sigmondkukla/wio-e5-test/wio-e5-top.png

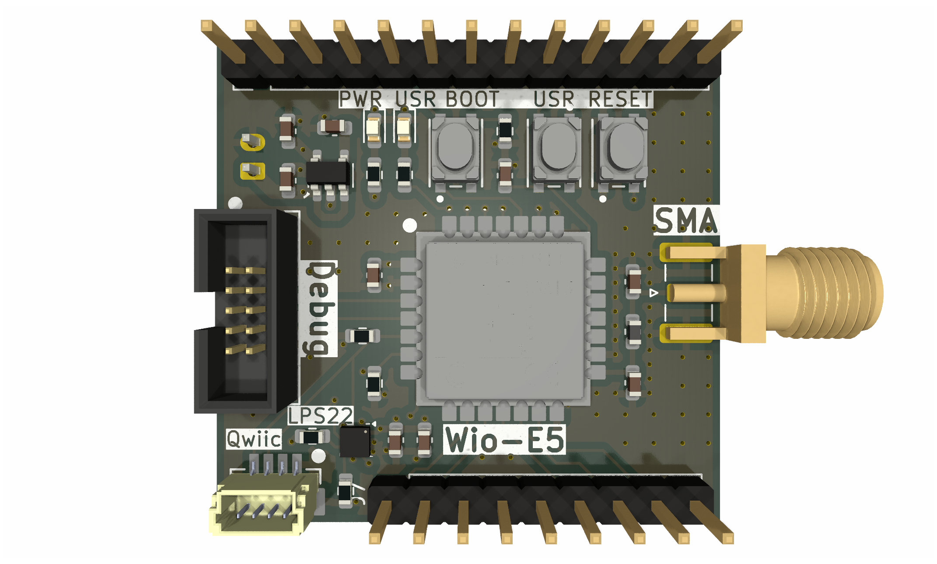
wio-e5-top.png
