sigmondkukla/wio-e5-test/plot/PCB.png

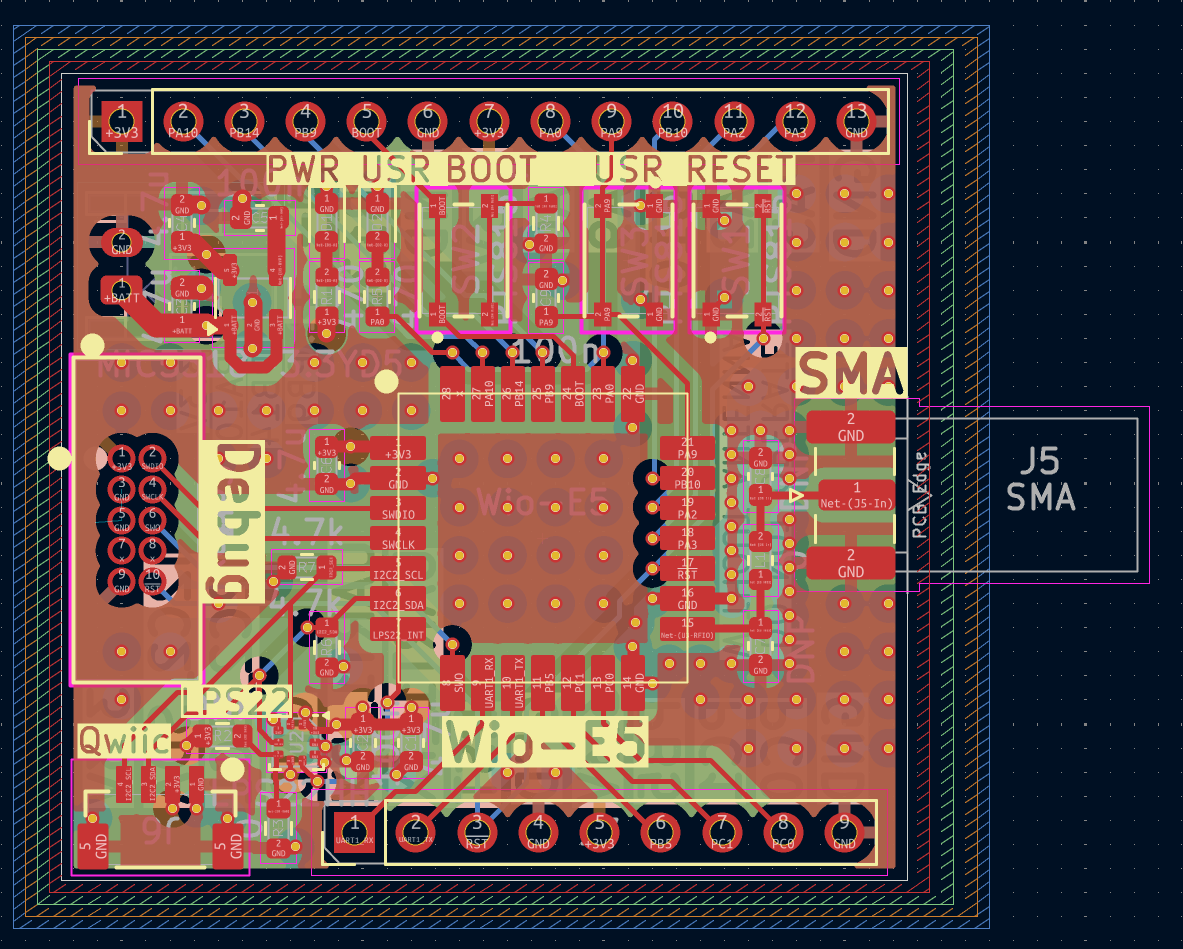
plot/PCB.png
