sigmondkukla/wio-e5-test/plot/wio-e5-test.pdf

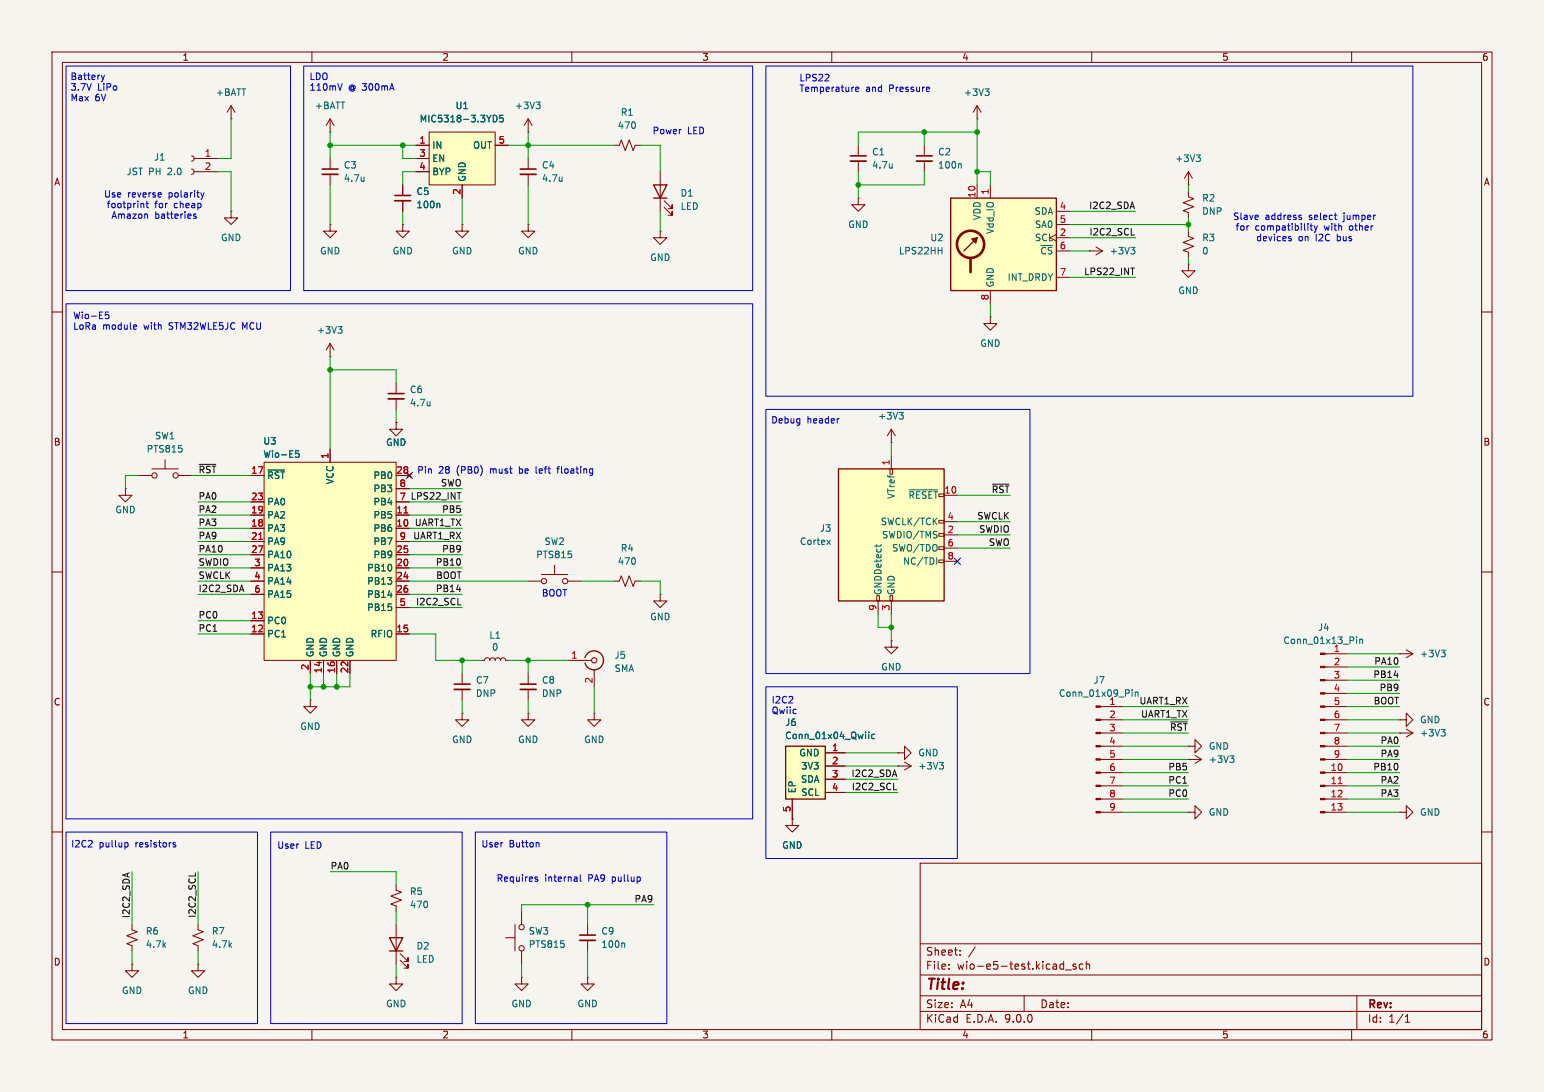
[picture p3: page 1]

1 GND 16 GND 22 PB3 8 PB4 7 PB5 11 RFIO 15 ~{RST} 17 PA2 19 PA3 18 PA13 3 PA14 4 PA15 6 PC0 13 PC1 12 PB0 28 PB6 10 PB7 9 PB9 25 PB10 20 PB13 24 PB14 26 PB15 5 C5

1 GND 16 GND 22 PB3 8 PB4 7 PB5 11 RFIO 15 ~{RST} 17 PA2 19 PA3 18 PA13 3 PA14 4 PA15 6 PC0 13 PC1 12 PB0 28 PB6 10 PB7 9 PB9 25 PB10 20 PB13 24 PB14 26 PB15 5 U3 Wio-E5 SW2 PTS815 VDD 10 Vdd_IO

R2 DNP
Slave address select jumper

LoRa module with STM32WLE5JC MCU

3 ~{RESET}10 SWCLK/TCK 4 SWDIO/TMS 2 SWO/TDO 6 NC/TDI 8

Id: 1/1 Title: File: wio-e5-test.kicad_sch Sheet: /
