sigmondkukla/wio-e5-test/wio-e5-test.kicad_pcb

## KiCad design wio-e5-test.kicad_pcb (2025-07-01)

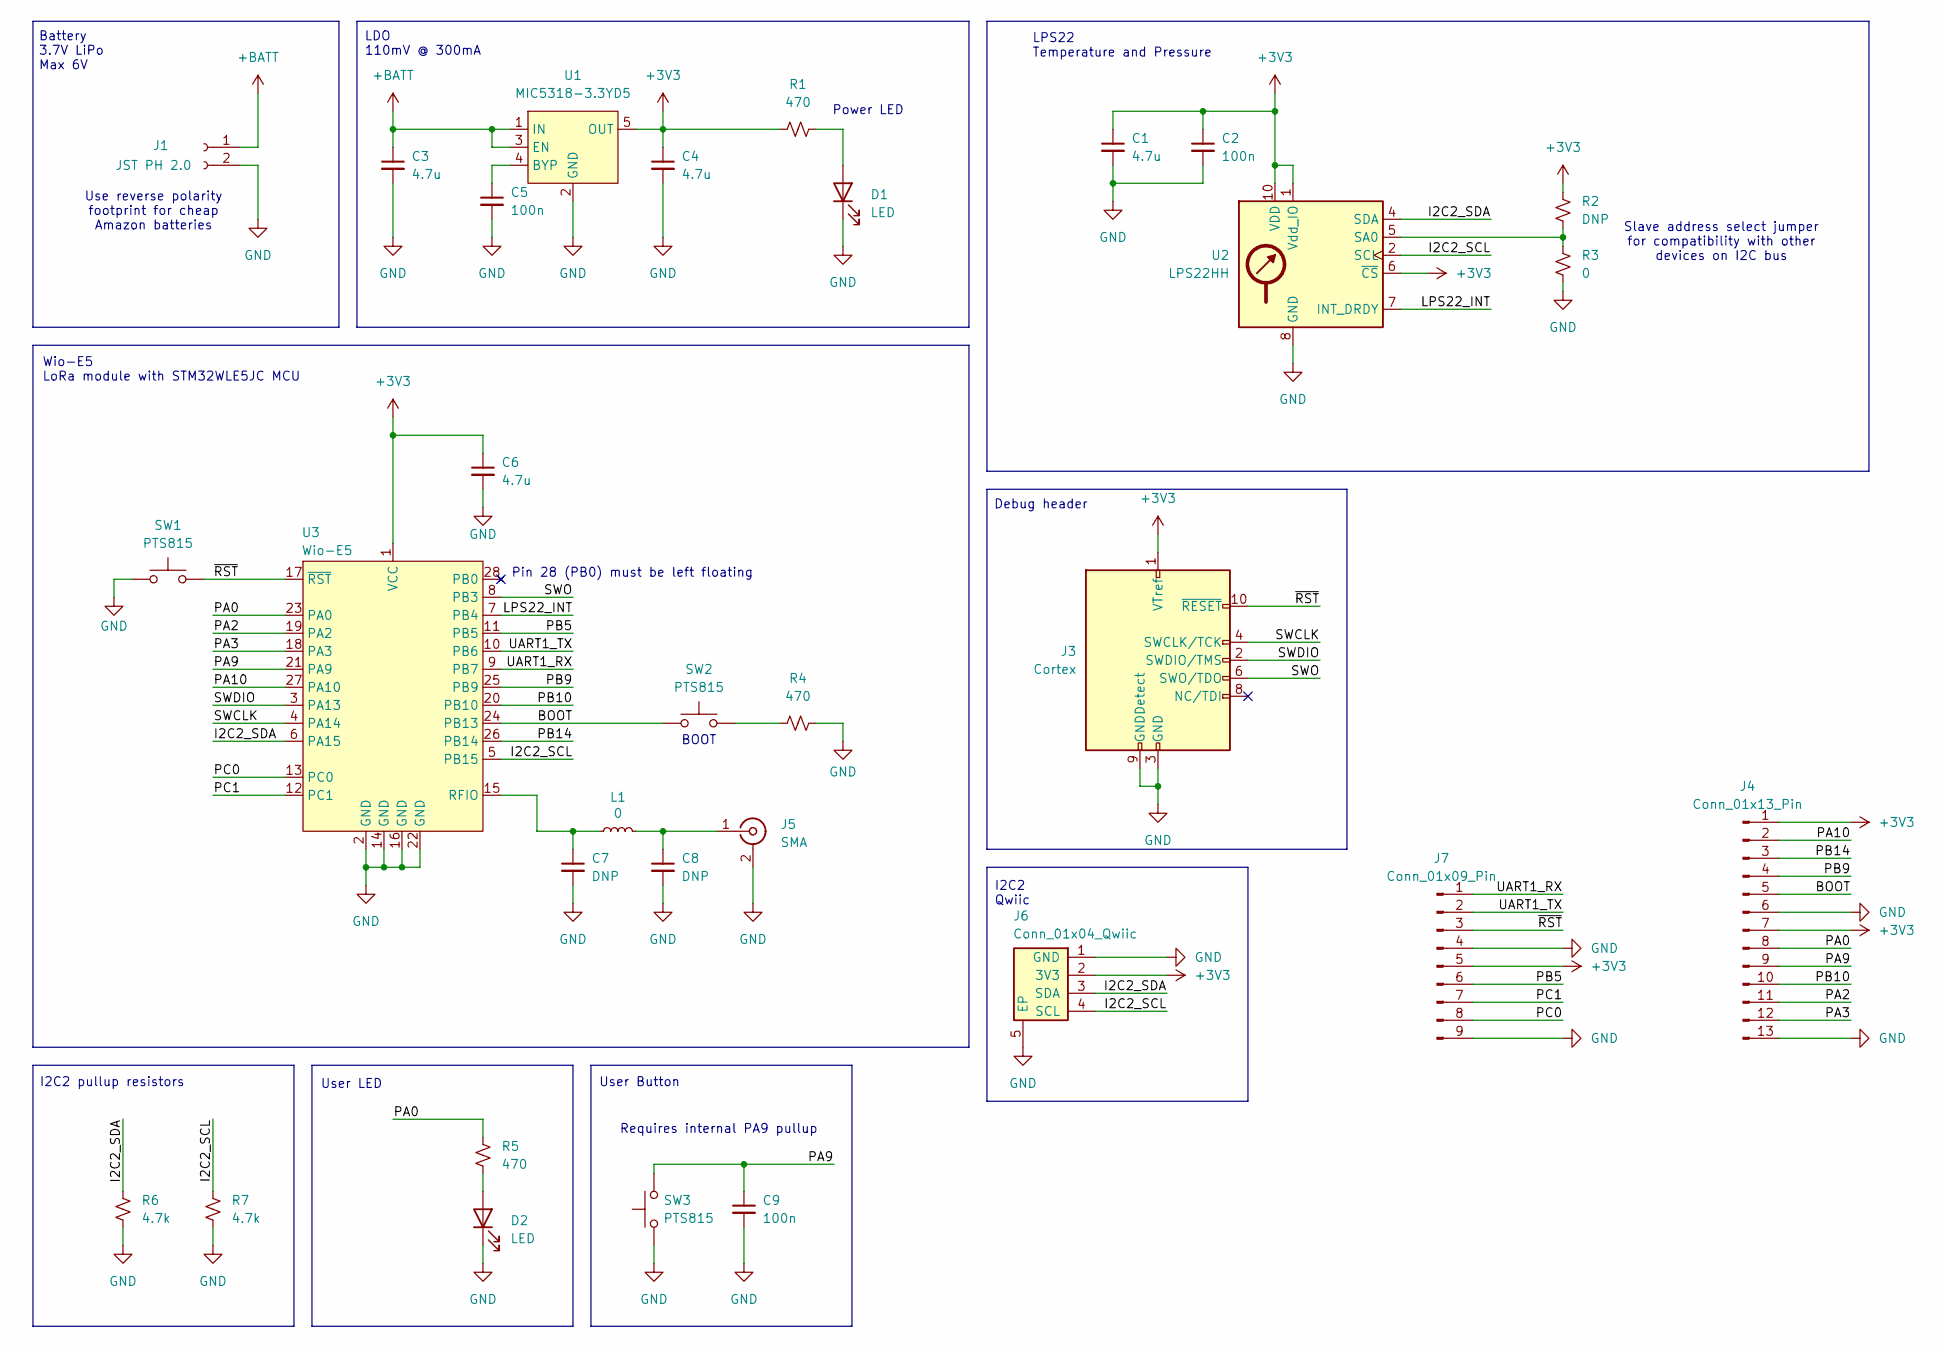
[picture p4: schematic wio-e5-test.kicad_sch]

Parts:
C1, C3, C4, C6: 4.7u; C_0603_1608Metric
C2, C5, C9: 100n; C_0603_1608Metric
C7, C8: DNP; C_0603_1608Metric
D1, D2: LED; LED_0603_1608Metric
J1: JST PH 2.0; JST_PH_S2B-PH-K_1x02_P2.00mm_Horizontal
J3: Cortex; CONN_3220-10-0100-00_CNC
J4: Conn_01x13_Pin; PinHeader_1x13_P2.54mm_Vertical
J5: SMA; SMA_Samtec_SMA-J-P-H-ST-EM1_EdgeMount
J6: Conn_01x04_Qwiic; CONN_JST-BM04B-SRSS-TB
J7: Conn_01x09_Pin; PinHeader_1x09_P2.54mm_Vertical
L1: 0; L_0603_1608Metric
R1, R4, R5: 470; R_0603_1608Metric
R2: DNP; R_0603_1608Metric
R3: 0; R_0603_1608Metric
R6, R7: 4.7k; R_0603_1608Metric
SW1, SW2, SW3: PTS815; SW_Push_PTS815_SJM_250_SMTR_LFS
U1: MIC5318-3.3YD5; SOT-23-5
U2: LPS22HH; ST_HLGA-10_2x2mm_P0.5mm_LayoutBorder3x2y
U3: Wio-E5

Connections:
+3V3: C1.1, C2.1, C4.1, C6.1, J3.1 (VTref), J4.1, J4.7, J6.2 (3V3), J7.5, R1.1, R2.1, U1.5 (OUT), U2.1 (Vdd_IO), U2.6 (~CS), U2.10 (VDD), U3.1 (VCC)
+BATT: C3.1, J1.1, U1.1 (IN), U1.3 (EN)
/BOOT: J4.5, SW2.1, U3.24 (PB13)
/I2C2_SCL: J6.4 (SCL), R7.1, U2.2 (SCL), U3.5 (PB15)
/I2C2_SDA: J6.3 (SDA), R6.1, U2.4 (SDA), U3.6 (PA15)
/LPS22_INT: U2.7 (INT_DRDY), U3.7 (PB4)
/PA0: J4.8, R5.1, U3.23 (PA0)
/PA2: J4.11, U3.19 (PA2)
/PA3: J4.12, U3.18 (PA3)
/PA9: C9.1, J4.9, SW3.2, U3.21 (PA9)
/PA10: J4.2, U3.27 (PA10)
/PB5: J7.6, U3.11 (PB5)
/PB9: J4.4, U3.25 (PB9)
/PB10: J4.10, U3.20 (PB10)
/PB14: J4.3, U3.26 (PB14)
/PC0: J7.8, U3.13 (PC0)
/PC1: J7.7, U3.12 (PC1)
/SWCLK: J3.4 (SWCLK/TCK), U3.4 (PA14)
/SWDIO: J3.2 (SWDIO/TMS), U3.3 (PA13)
/SWO: J3.6 (SWO/TDO), U3.8 (PB3)
/UART1_RX: J7.1, U3.9 (PB7)
/UART1_TX: J7.2, U3.10 (PB6)
/~RST: J3.10 (~RESET), J7.3, SW1.2, U3.17 (~RST)
GND: C1.2, C2.2, C3.2, C4.2, C5.2, C6.2, C7.2, C8.2, C9.2, D1.1 (K), D2.1 (K), J1.2, J3.3 (GND), J3.5 (GND), J3.9 (GNDDetect), J4.6, J4.13, J5.2 (Ext), J6.1 (GND), J6.5 (EP), J7.4, J7.9, R3.2, R4.2, R6.2, R7.2, SW1.1, SW3.1, U1.2 (GND), U2.3 (GND), U2.8 (GND), U2.9 (GND), U3.2 (GND), U3.14 (GND), U3.16 (GND), U3.22 (GND)
unnamed: D1.2 (A), R1.2
unnamed: D2.2 (A), R5.2
unnamed: C8.1, J5.1 (In), L1.2
unnamed: R4.1, SW2.2
unnamed: C5.1, U1.4 (BYP)
unnamed: R2.2, R3.1, U2.5 (SA0)
unnamed: C7.1, L1.1, U3.15 (RFIO)

Notes on the sheet:
LPS22 Temperature and Pressure
User Button
Slave address select jumper for compatibility with other devices on I2C bus
Wio-E5 LoRa module with STM32WLE5JC MCU
I2C2 pullup resistors
Battery 3.7V LiPo Max 6V
Power LED
I2C2 Qwiic
LDO 110mV @ 300mA
Pin 28 (PB0) must be left floating
BOOT
Requires internal PA9 pullup
Debug header
Use reverse polarity footprint for cheap Amazon batteries
User LED

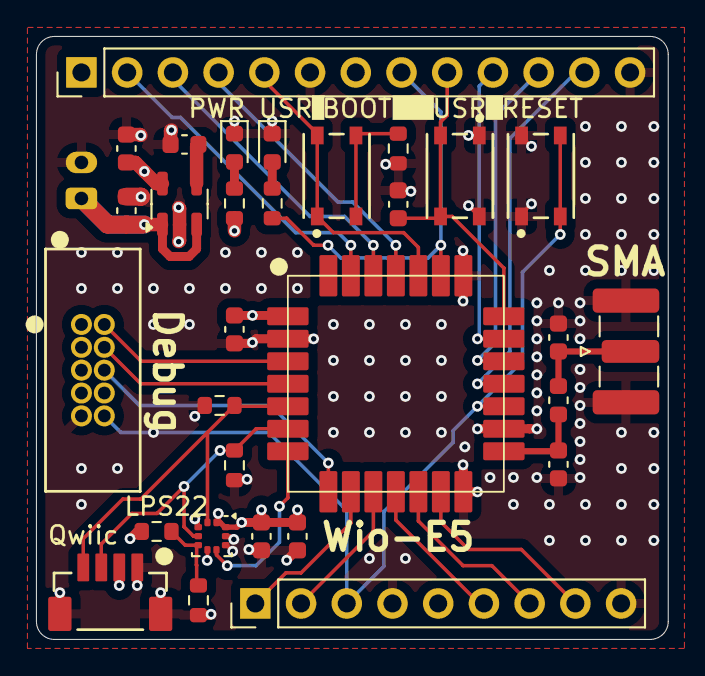
[picture p5: board wio-e5-test.kicad_pcb from above]

Board: 4 copper layers, 35.1 x 33.5 mm, 31 parts (1 on the bottom side), 31 nets.
